Xorlent/Ender-5-Max/README.md

# Ender-5-Max
Creality Ender 5 Max resources and information
### [Bed Leveling Shims and Instructions](https://github.com/Xorlent/Ender-5-Max/tree/main/Bed%20Shims) ###
### [Print Head Cable Holddown for Enclosure](https://github.com/Xorlent/Ender-5-Max/tree/main/Cable%20Holddown) ###
