Xorlent/Ender-5-Max/Bed Shims/Bed Shim .5mm.step

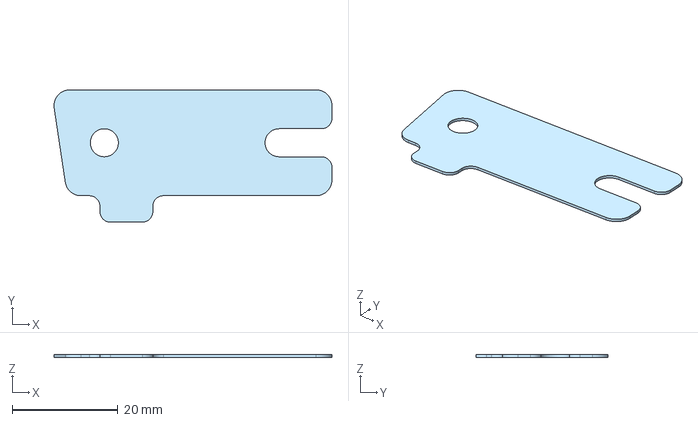
[picture p3: CAD file, 2025-04-10]
Bed Shims/Bed Shim .5mm.step
52.5 x 25.0 x 0.5 mm
