Xorlent/Ender-5-Max/Cable Holddown/Base.step

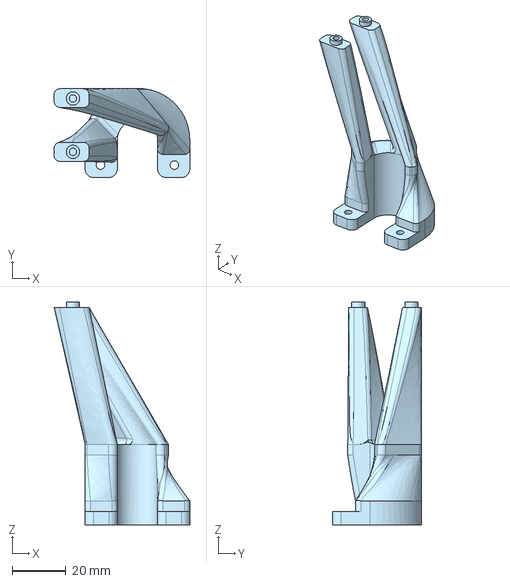
[picture p4: CAD file, 2025-06-02]
Cable Holddown/Base.step
50.5 x 33.1 x 83.0 mm
