Xorlent/Ender-5-Max/Bed Shims/Bed Shim .125mm.step

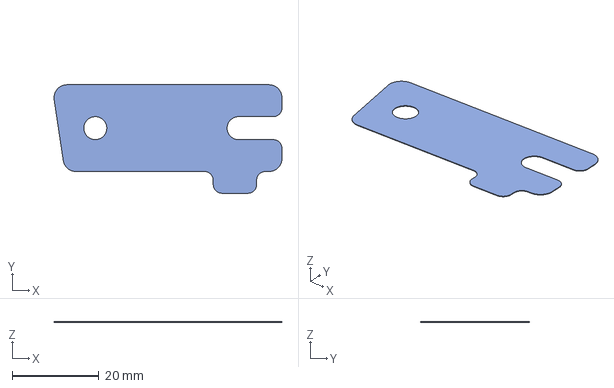
[picture p5: CAD file, 2025-04-10]
Bed Shims/Bed Shim .125mm.step
52.5 x 25.0 x 0.125 mm
