Xorlent/Ender-5-Max/Cable Holddown/Cap.step

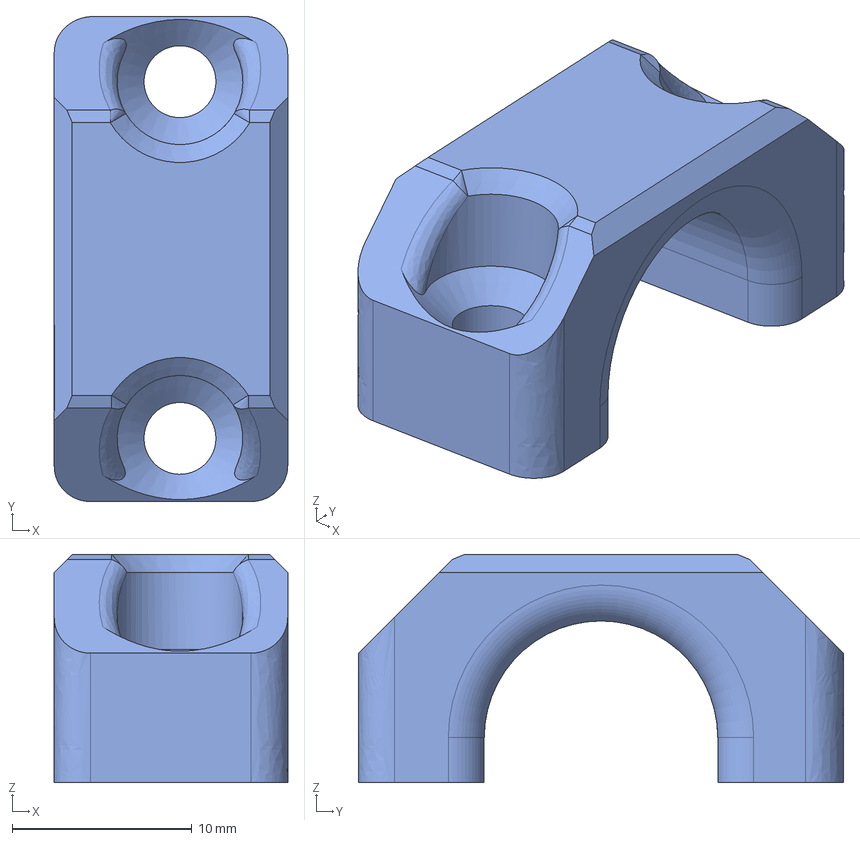
[picture p6: CAD file, 2025-06-02]
Cable Holddown/Cap.step
13.0 x 27.0 x 12.7 mm
