Xorlent/Ender-5-Max/Bed Shims/Bed Shim .25mm.step

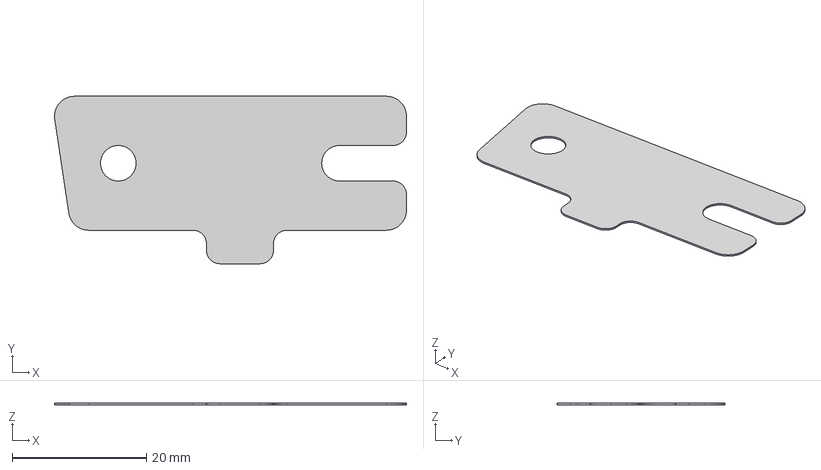
[picture p7: CAD file, 2025-04-10]
Bed Shims/Bed Shim .25mm.step
52.5 x 25.0 x 0.25 mm
